IGSEdigheim/Classroom-Sensor/img/Classroom-Sensor_2D.PNG

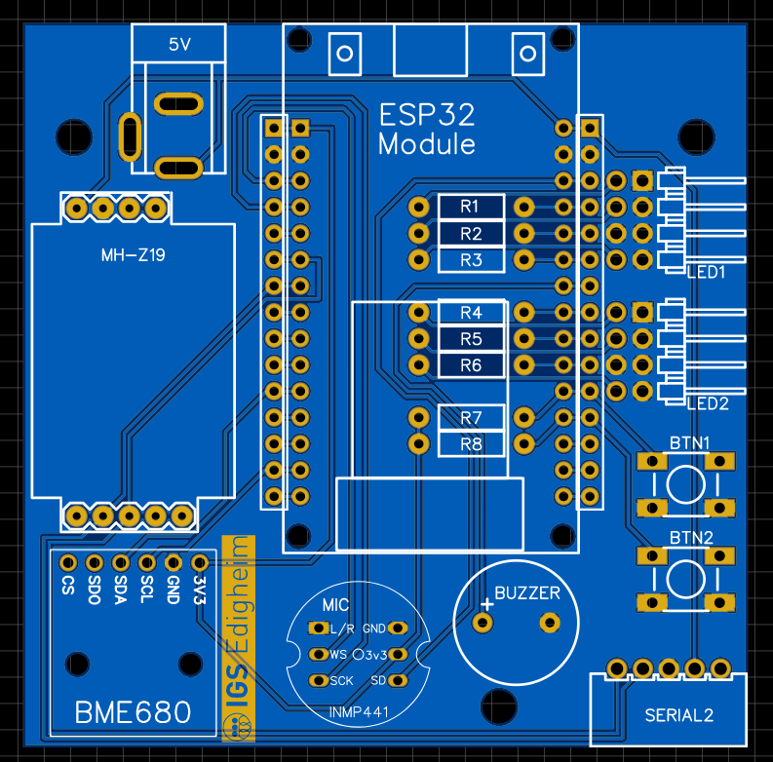
img/Classroom-Sensor_2D.PNG
