IGSEdigheim/Classroom-Sensor/img/Classroom-Sensor_3D.PNG

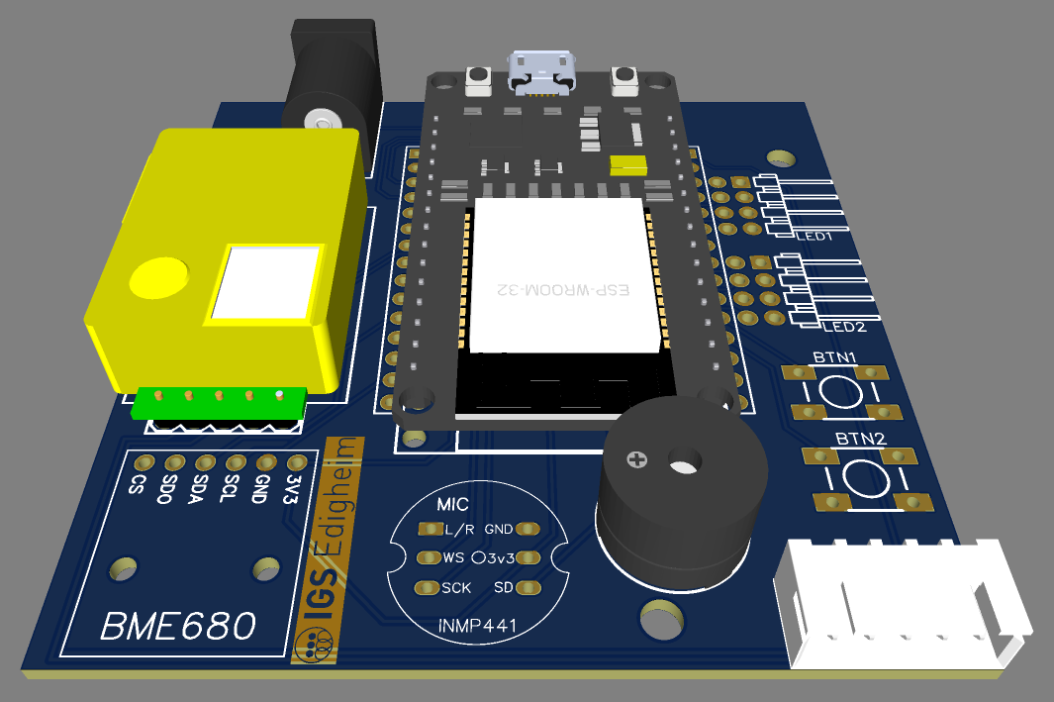
img/Classroom-Sensor_3D.PNG
