IGSEdigheim/Classroom-Sensor/img/IAQ.png

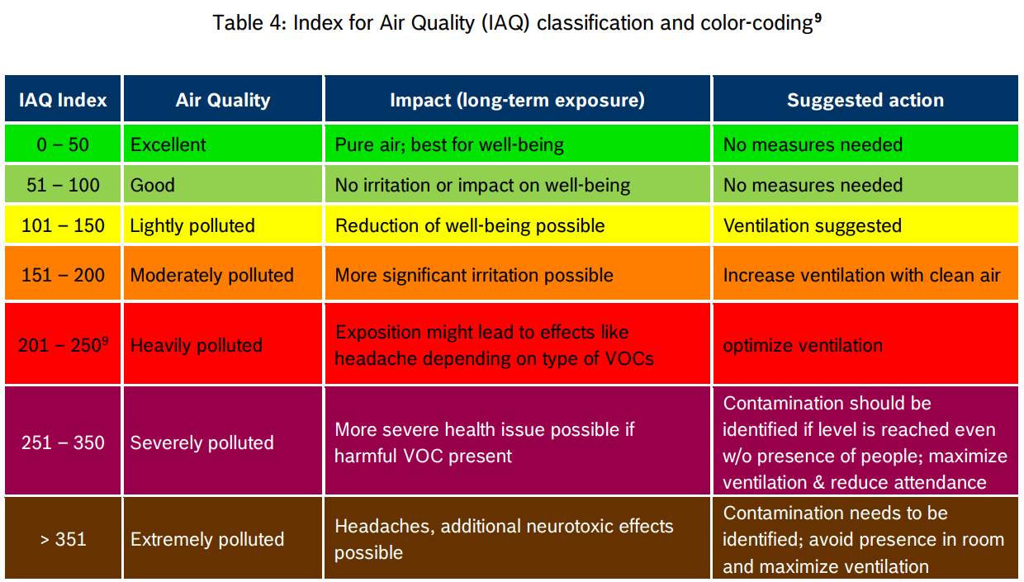
img/IAQ.png
