IGSEdigheim/Classroom-Sensor/(commit log)

2021-04-09 new board
2021-11-07 new task led
